Joah-wu/Acho/acho/Hardware/PCBs/README.md

# PCB资料

| 目录 | 内容 |
| --- | --- |
| `Acho_Main` | 主板原理图、BOM、交互BOM与Gerber压缩包 |
| `Audio_Core` | 音频子板原理图、BOM、交互BOM与Gerber压缩包 |

原理图用于连接与电源检查，BOM用于选型和采购，Gerber用于制造，交互BOM用于装配定位。以当前目录实际保留的文件为准。

主板承载STM32、显示、SD、NFC、ESP32接口和用户交互；音频子板承载WM8960、功放/扬声器相关电路。两块板的连接、供电和信号定义应以各自原理图为准。
