Joah-wu/Acho/model/README.md

# model

关键词识别模型及配套脚本。

| 路径 | 作用 |
| --- | --- |
| `keyword_spotting/` | 模型网络、数据处理、训练与推理代码 |
| `scripts/` | 数据准备、训练、测试与ONNX导出脚本 |
| `*.onnx` / 模型资源 | 提供给X-CUBE-AI或离线验证的模型文件 |

Python缓存和训练输出为本地过程文件，不应提交。

模型用于离线关键词识别；需要部署到STM32时，使用导出的ONNX模型交给X-CUBE-AI生成推理代码。训练数据、检查点和实验日志应与可复现的脚本配置分开管理。
