Joah-wu/Acho/acho/Hardware/PCBs/Acho_Main/BOM_Acho-main.xlsx

No. | Quantity | Comment | Designator | Footprint | Value | Device | Supplier | Supplier Part | Manufacturer | Manufacturer Part | Tolerance
1 | 1 | 4000Hz | BUZZER1 | BUZ-SMD_L5.0-W5.5-P4.60 | 4000Hz | 5020蜂鸣器 | LCSC | C94598 | 华能 | MLT-5020
2 | 18 | 100nF | C1,C5,C6,C9,C10,C11,C12,C13,C14,C17,C19,C27,C28,C38,C44,C45,C48,C49 | C0402 | 100nF | CAP_0402
3 | 2 | 12pF | C2,C3 | C0402 | 12pF | CAP_0402
4 | 2 | 20pF | C4,C7 | C0402 | 20pF | CAP_0402
5 | 5 | 10uF | C8,C18,C26,C29,C47 | C0603 | 10uF | CAP_0603
6 | 2 | 22uf | C34,C36 | C0603 |  | 22uf
7 | 2 | 4.7uF | C42,C50 | C0603 | 4.7uF | CL10A475KO8NNNC | LCSC | C19666 | SAMSUNG(三星) | CL10A475KO8NNNC | ±10%
8 | 1 | 1uF | C46 | C0402 | 1uF | CAP_0402
9 | 2 | SS34-A | D1,D2 | SMA_L4.3-W2.6-LS5.2-RD |  | SS34-A | LCSC | C143201 | FMS(美丽微) | SS34-A
10 | 1 | DSS14 | D6 | SOD-123_L2.8-W1.8-LS3.7-RD |  | DSS14 | LCSC | C59293 | STARSEA | DSS14
11 | 1 | 4.7uH-INDUCTOR-0603 | L2 | IND-SMD_L1.6-W1.0 |  | 10uH-INDUCTOR-0603 | LCSC | C9900016650 | YJYCOIN(益嘉源) | 4.7uH-INDUCTOR-0603
12 | 1 | FCM1608KF-601T03 | L4 | L0603 |  | FCM1608KF-601T03 | LCSC | C141723 | TAI-TECH(台庆) | FCM1608KF-601T03 | ±25%
13 | 1 | LED_0603-G | LED2 | LED_0603 |  | LED_0603-G
14 | 1 | LED_0603-R | LED3 | LED_0603 |  | LED_0603-R
15 | 1 | S8550 | Q1 | SOT-23-3_L2.9-W1.3-P1.90-LS2.4-BR |  | S8550 | LCSC | C2931720 | Doeshare(德芯) | S8550
16 | 1 | S8050_SOT_NPN | Q4 | S8050_SOT-23 |  | S8050_SOT_NPN
17 | 15 | 10K | R1,R2,R3,R6,R7,R13,R18,R19,R20,R21,R22,R29,R31,R71,R72 | R0402 | 10K | Res_0402
18 | 3 | 2K | R4,R5,R36 | R0402 | 2K | Res_0402
19 | 2 | 5.1K | R8,R9 | R0402 | 10K | Res_0402
20 | 1 | 10K | R11 | R0603 | 10K | Res_0603
21 | 2 | 0 | R14,R15 | R0603 | 0 | Res_0603
22 | 2 | 1.2K | R16,R32 | R0402 | 1.2K | Res_0402
23 | 3 | 47K | R25,R26,R27 | R0402 | 10K | Res_0402
24 | 1 | 0Ω | R69 | R0805 | 0Ω | 0805W8F0000T5E | LCSC | C17477 | UNI-ROYAL(厚声) | 0805W8F0000T5E | ±1%
25 | 1 | 三脚开关 | SW1 | 拨动开关封装 |  | 三脚开关
26 | 1 | Test-Point | TP1 | Test-Point-0.5mm |  | Test-Point
27 | 1 | STM32F446RET6 | U1 | LQFP-64_L10.0-W10.0-P0.50-LS12.0-BL |  | STM32F446RET6 | LCSC | C69336 | ST(意法半导体) | STM32F446RET6
28 | 2 | 二脚小龟直 | U2,U24 | KEY-SMD_L3.9-W3.0-LS5.0 |  | 二脚小龟直 | LCSC | C2940098 |  | 二脚小龟直
29 | 1 | 13.56MHz | U3 | SO-8_L4.9-W3.9-P1.27-LS6.0-BL | 13.56MHz | ST25DV64KC-IE6S3 | LCSC | C3304275 | ST(意法半导体) | ST25DV64KC-IE6S3
30 | 1 | CH549F | U4 | QFN-28_L4.0-W4.0-P0.40-BL-EP |  | CH549F | LCSC | C367229 | WCH(南京沁恒) | CH549F
31 | 1 | BX-SH1.0-3PLT | U5 | CONN-SMD_3P-P1.00_BX-SH1.0-3PLT |  | BX-SH1.0-3PLT | LCSC | C18077916 | Bossie(博锡) | BX-SH1.0-3PLT
32 | 1 | TP4056 | U7 | ESOP-8_L4.9-W3.9-P1.27-LS6.0-BL-EP |  | TP4056 | LCSC | C9900002169 |  | TP4056
33 | 1 | SIQ-02FVS3 | U9 | SW-SMD_SIQ-02FVS3_1 |  | SIQ-02FVS3 | LCSC | C2925423 | MITSUMI(美上美) | SIQ-02FVS3
34 | 1 | 自弹TF卡座TFAA | U10 | SIM-SMD_C9900015645 |  | TF_Card | LCSC | C9900015645 | null | 自弹TF卡座TFAA
35 | 2 | AO3401 | U11,U12 | SOT-23-3_L2.9-W1.6-P1.90-LS2.8-BR |  | AO3401 | LCSC | C9900008520 |  | AO3401
36 | 1 | FUSE0603 | U13 | F0603 |  | FUSE0603 | LCSC | C9900023011 |  | FUSE0603
37 | 1 | RT9013-33GB | U14 | SOT-23-5_L2.9-W1.6-P0.95-LS2.8-BR |  | RT9013-33GB_C19268157 | LCSC | C19268157 | TECH PUBLIC(台舟) | RT9013-33GB
38 | 1 | Acho音频模块接口 | U15 | Acho音频模块接口封装 |  | Acho音频模块接口
39 | 1 | SX1308 | U17 | SOT-23-6_L2.9-W1.6-P0.95-LS2.8-BR |  | SX1308 | LCSC | C78162 | SX | SX1308
40 | 1 | 1N4148 | U19 | SOD-123_L2.7-W1.7-LS3.8-RD |  | 1N4148 | LCSC | C9900009645 |  | 1N4148
41 | 1 | BX-SH1.0-2PWT | U20 | CONN-SMD_2P-P1.00_BX-SH1.0-2PWT |  | BX-SH1.0-2PWT | LCSC | C18077908 | Bossie(博锡) | BX-SH1.0-2PWT
42 | 1 | FPC10-0.5 | U22 | FPC-SMD_P0.5-10P_FGS-XJ-H2.0 |  | FPC10-0.5 | LCSC | C9900025035 |  | FPC10-0.5
43 | 1 | ESP32-C3-MINI-1-N4 | U23 | WIFIM-SMD_ESP32-C3-MINI-1 |  | ESP32-C3-MINI-1-N4 | LCSC | C2838502 | ESPRESSIF(乐鑫) | ESP32-C3-MINI-1-N4
44 | 1 | KH-TYPE-C-16P | USB1 | USB-C-SMD_KH-TYPE-C-16P |  | USB-TYPE-C-16P | LCSC | C709357 | kinghelm(金航标) | KH-TYPE-C-16P
45 | 1 | 32.768kHz | X1 | OSC-SMD_L3.2-W1.5 | 32.768kHz | X321532768KGD2SI | LCSC | C620155 | YXC(扬兴晶振) | X321532768KGD2SI
46 | 1 | 12MHz | X2 | OSC-SMD_4P-L3.2-W2.5-BL | 12MHz | X322512MSB4SI | LCSC | C9002 | YXC(扬兴晶振) | X322512MSB4SI
