Joah-wu/Acho/acho/Hardware/PCBs/Audio_Core/BOM_audio-core.xlsx

No. | Quantity | Comment | Designator | Footprint | Value | Device | Supplier | Supplier Part | Manufacturer | Manufacturer Part | Tolerance
1 | 6 | 100nF | C1,C5,C8,C9,C10,C11 | C0603 | 100nF | CAP_0603
2 | 3 | 10uF | C2,C3,C4 | C0603 | 10uF | CAP_0603
3 | 3 | 1uF | C6,C7,C12 | C0603 | 1uF | CAP_0603
4 | 1 | PJ-393 | CN1 | AUDIO-TH_PJ-393 |  | PJ-393 | LCSC | C920237 | XUNPU(讯普) | PJ-393
5 | 1 | 2.54-1*10P针 | H1 | HDR-TH_10P-P2.54-V-M-1 |  | HDR-M_2.54_1x10P | LCSC | C57369 | BOOMELE(博穆精密) | 2.54-1*10P针
6 | 1 | Acho音频模块扬声器接口 | H2 | Acho音频模块扬声器接口封装 |  | Acho音频模块扬声器接口
7 | 1 | LED_0603-G | LED1 | LED_0603 |  | LED_0603-G
8 | 1 | AOS3729A-T42-NXC | MIC1 | MIC-SMD_L3.8-W3.00-TL |  | AOS3729A-T42-NXC | LCSC | C338759 | SANICO(莎尼可) | AOS3729A-T42-NXC
9 | 2 | 2.2K | R1,R2 | R0603 | 2.2K | Res_0603
10 | 5 | 10K | R3,R4,R5,R7,R10 | R0603 | 10K | Res_0603
11 | 1 | 0 | R6 | R0603 | 0 | Res_0603
12 | 1 | 47K | R8 | R0603 | 47K | Res_0603
13 | 1 | 15K | R9 | R0603 | 15K | Res_0603
14 | 1 | WM8960CGEFL/RV | U1 | qfn-32_l5.0-w5.0-p0.50-tl-ep3.5 |  | WM8960CGEFL/RV_C323847 | LCSC | C323847 |  | WM8960CGEFL/RV
