Joah-wu/Acho/acho/Hardware/Solids/上框.SLDPRT

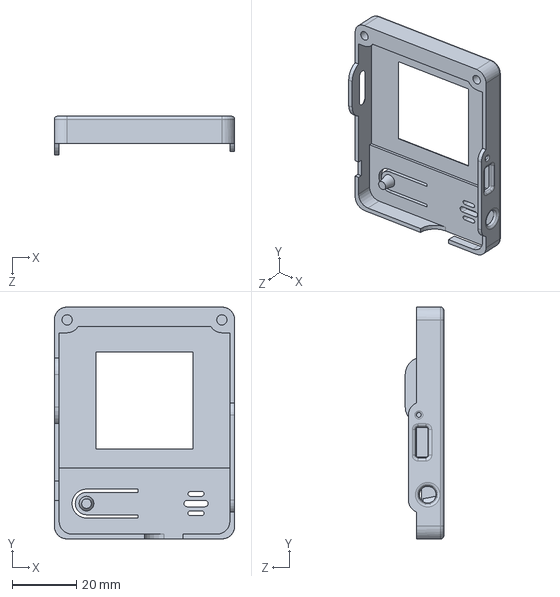
[picture p42: CAD file, 2026-11-07]
acho/Hardware/Solids/上框.SLDPRT
56.0 x 72.0 x 12.0 mm
