Joah-wu/Acho/acho/Hardware/Solids/下框.SLDPRT

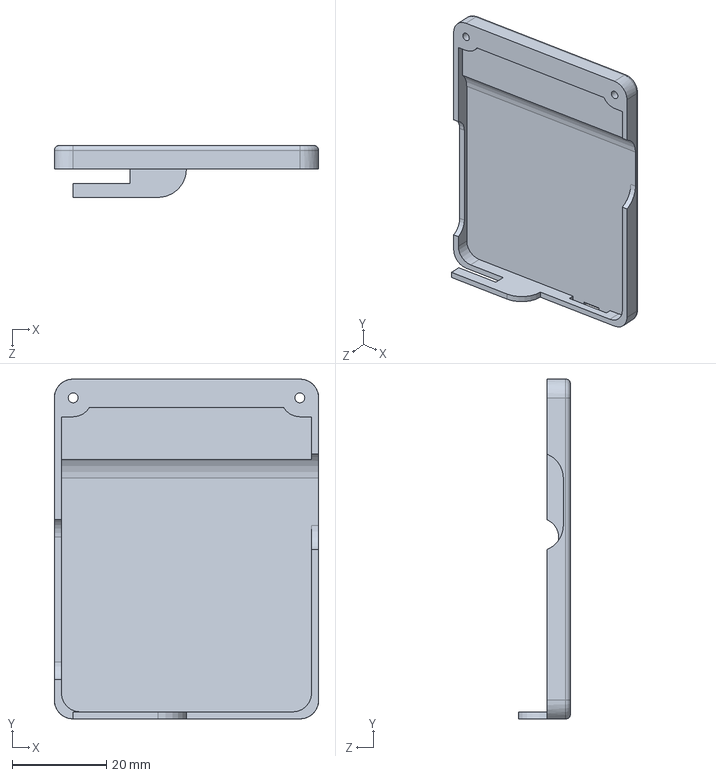
[picture p43: CAD file, 2026-11-07]
acho/Hardware/Solids/下框.SLDPRT
56.0 x 72.0 x 11.0 mm
