Joah-wu/Acho/acho/Hardware/Solids/acho_audio_kit.step

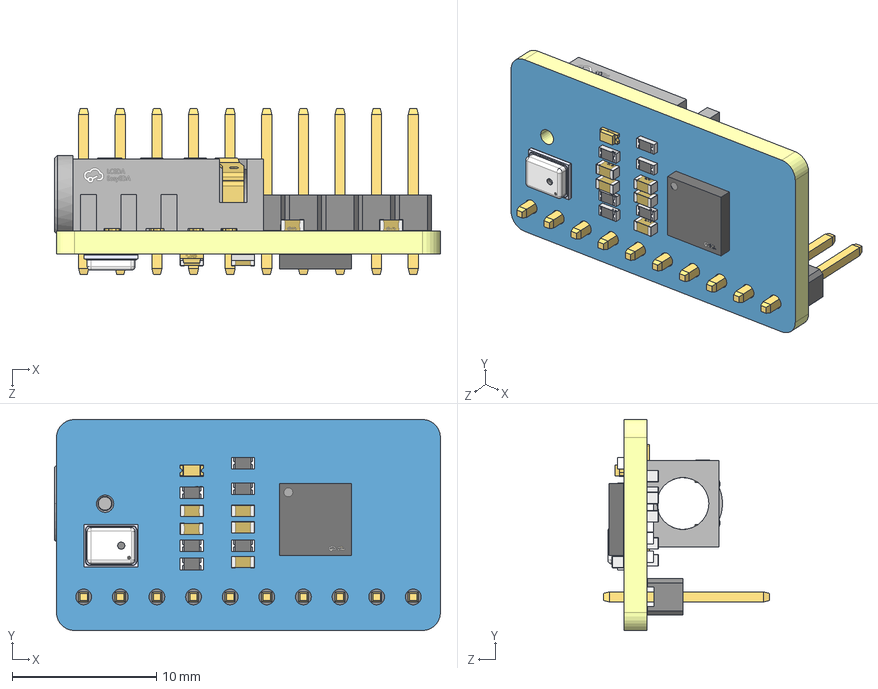
[picture p44: CAD file, 2026-11-07]
acho/Hardware/Solids/acho_audio_kit.step
26.8 x 14.6 x 11.5 mm
COMPOUND.step.step.step.step
COMPOUND-0.step.step.step.step x 10
COMPOUND-1.step.step.step.step
SOLID.step.step.step.step x 12
COMPOUND-2.step.step.step.step
COMPOUND-3.step.step.step.step
COMPOUND-4.step.step.step.step
Board.step.step.step.step
