Joah-wu/Acho/(list of files, cad)

Other CAD files:
acho/Hardware/Solids/acho_pcb.step
acho/Hardware/Solids/acho_pcb.SLDASM
