Joah-wu/Acho/acho/Hardware/PCBs/Audio_Core/SCH_audio-core-sch.pdf

### AGND

# C2 ¹⁰uF

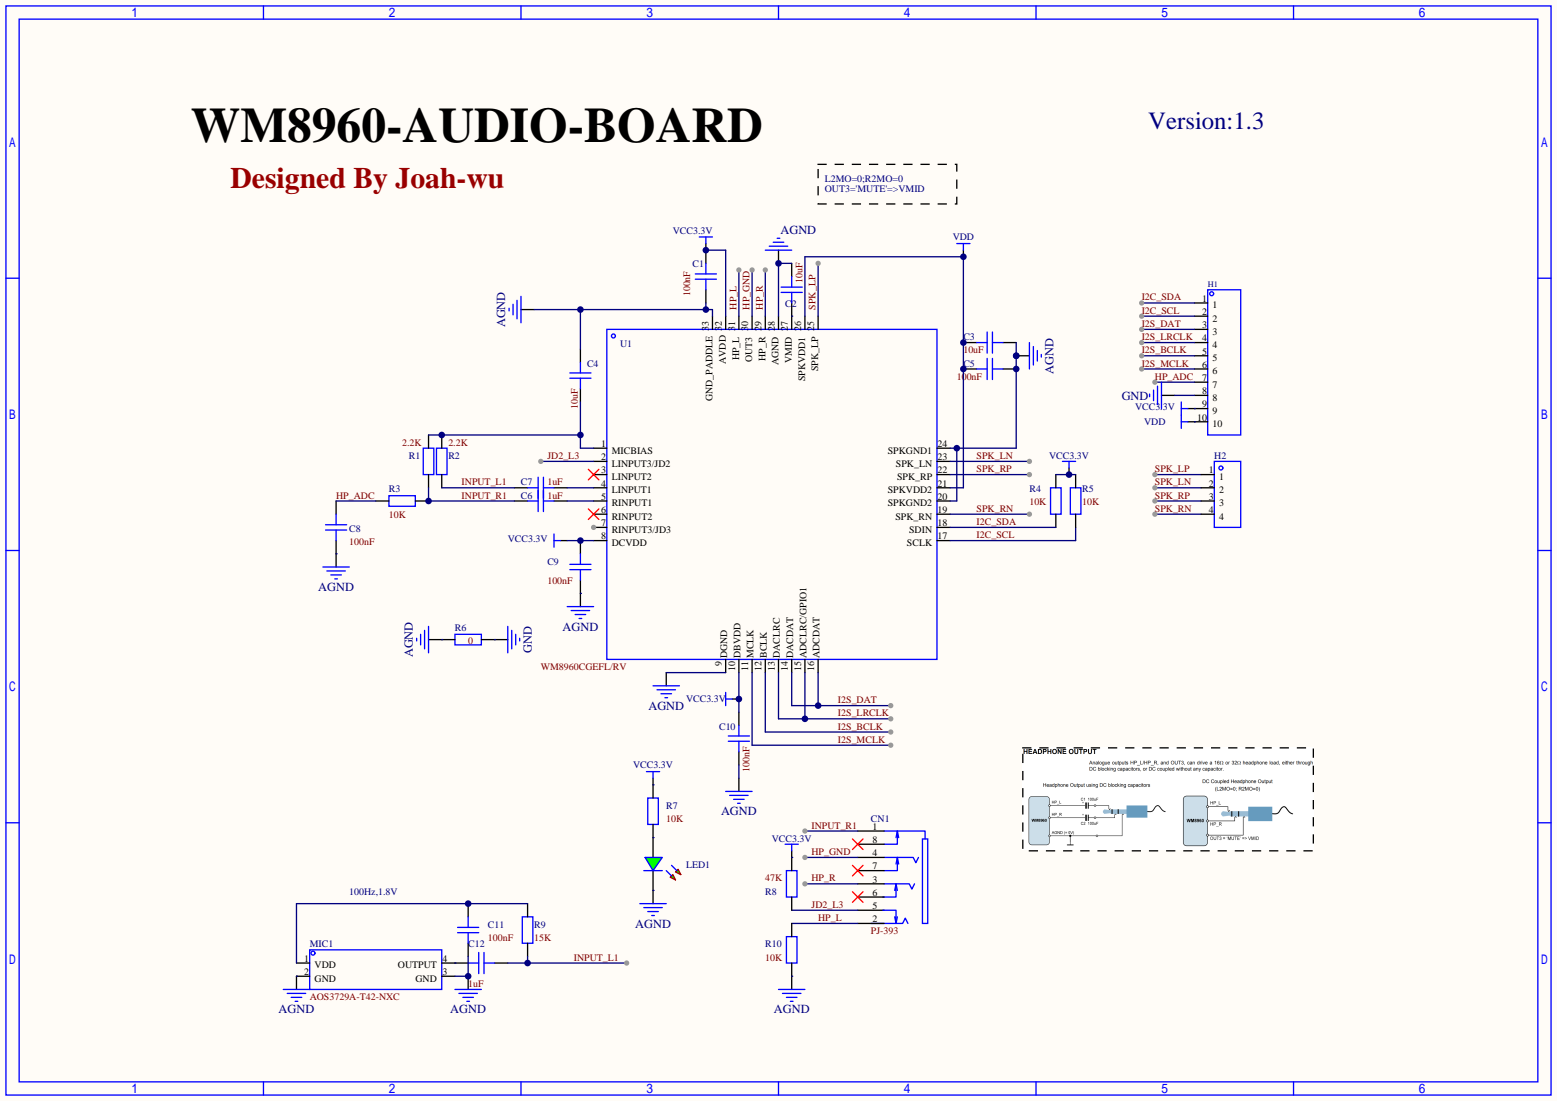
[picture p45: page 1]

WM8960-AUDIO-BOARD
Designed By Joah-wu AGND
