Joah-wu/Acho/acho/Hardware/PCBs/Acho_Main/SCH_Acho-sch.pdf

# 48 PA14 49 PA15 50 PC10 51 PC11 52 PC12 53 PD2 54 PB3 55 PB4 56 PB5 57 PB6

### GND

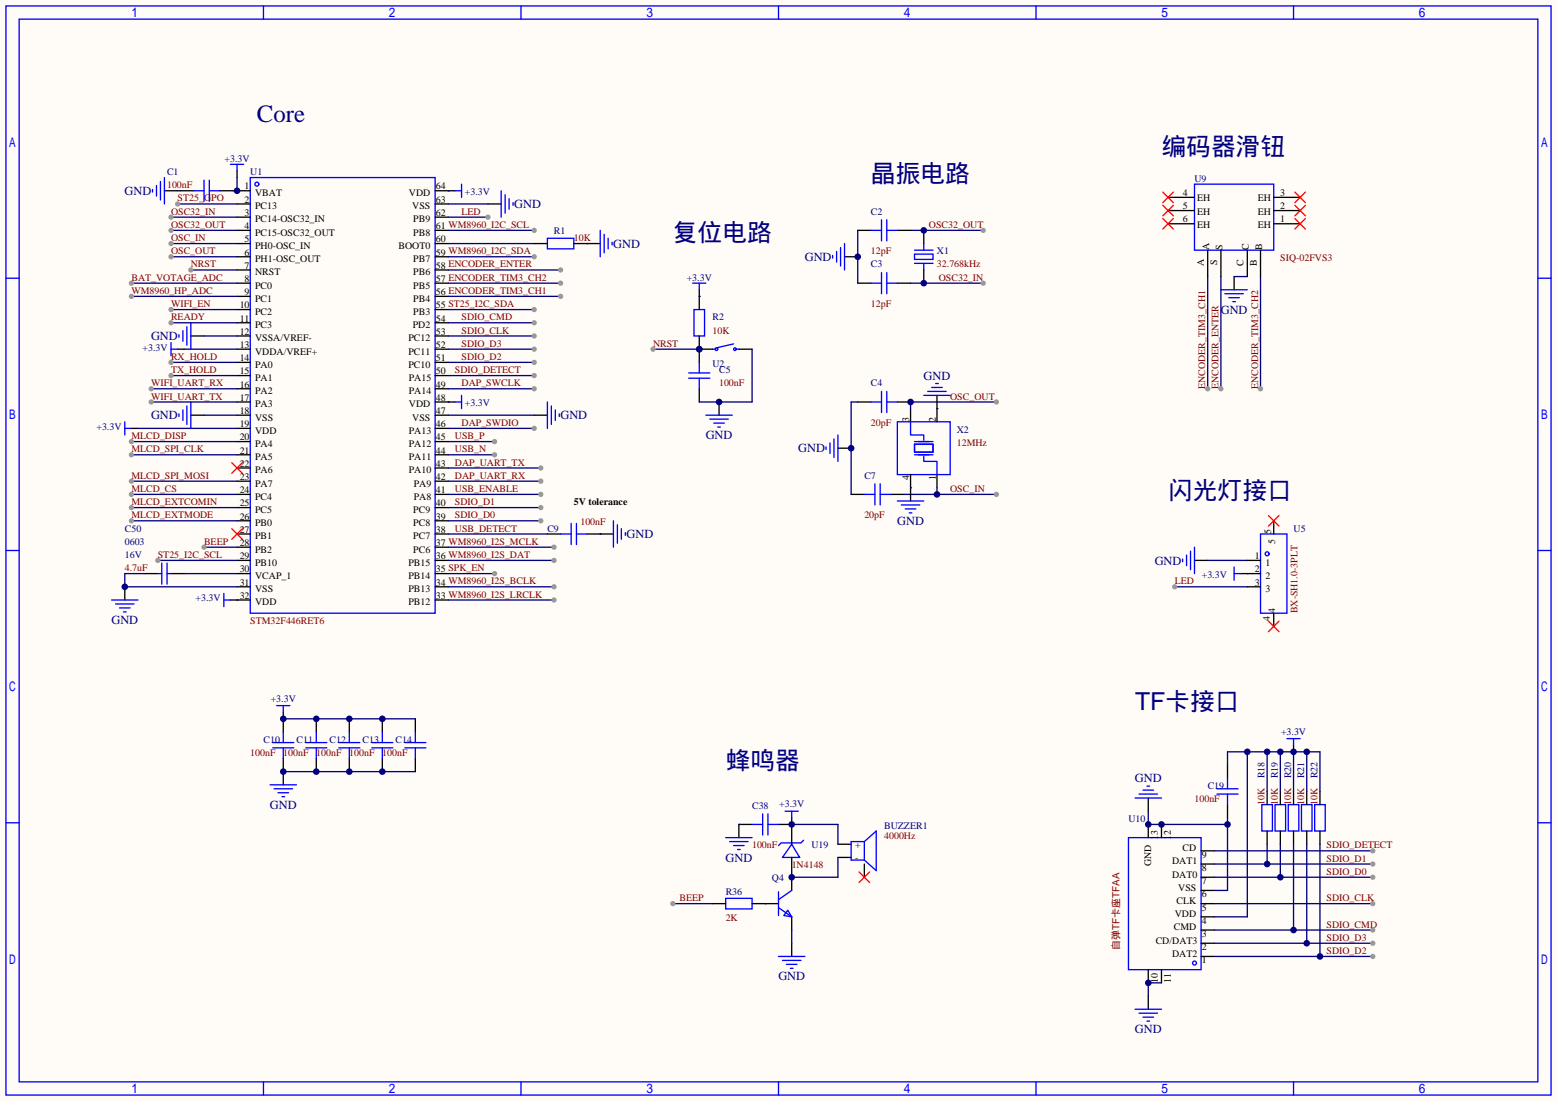
[picture p46: page 1]

### GND

### GND

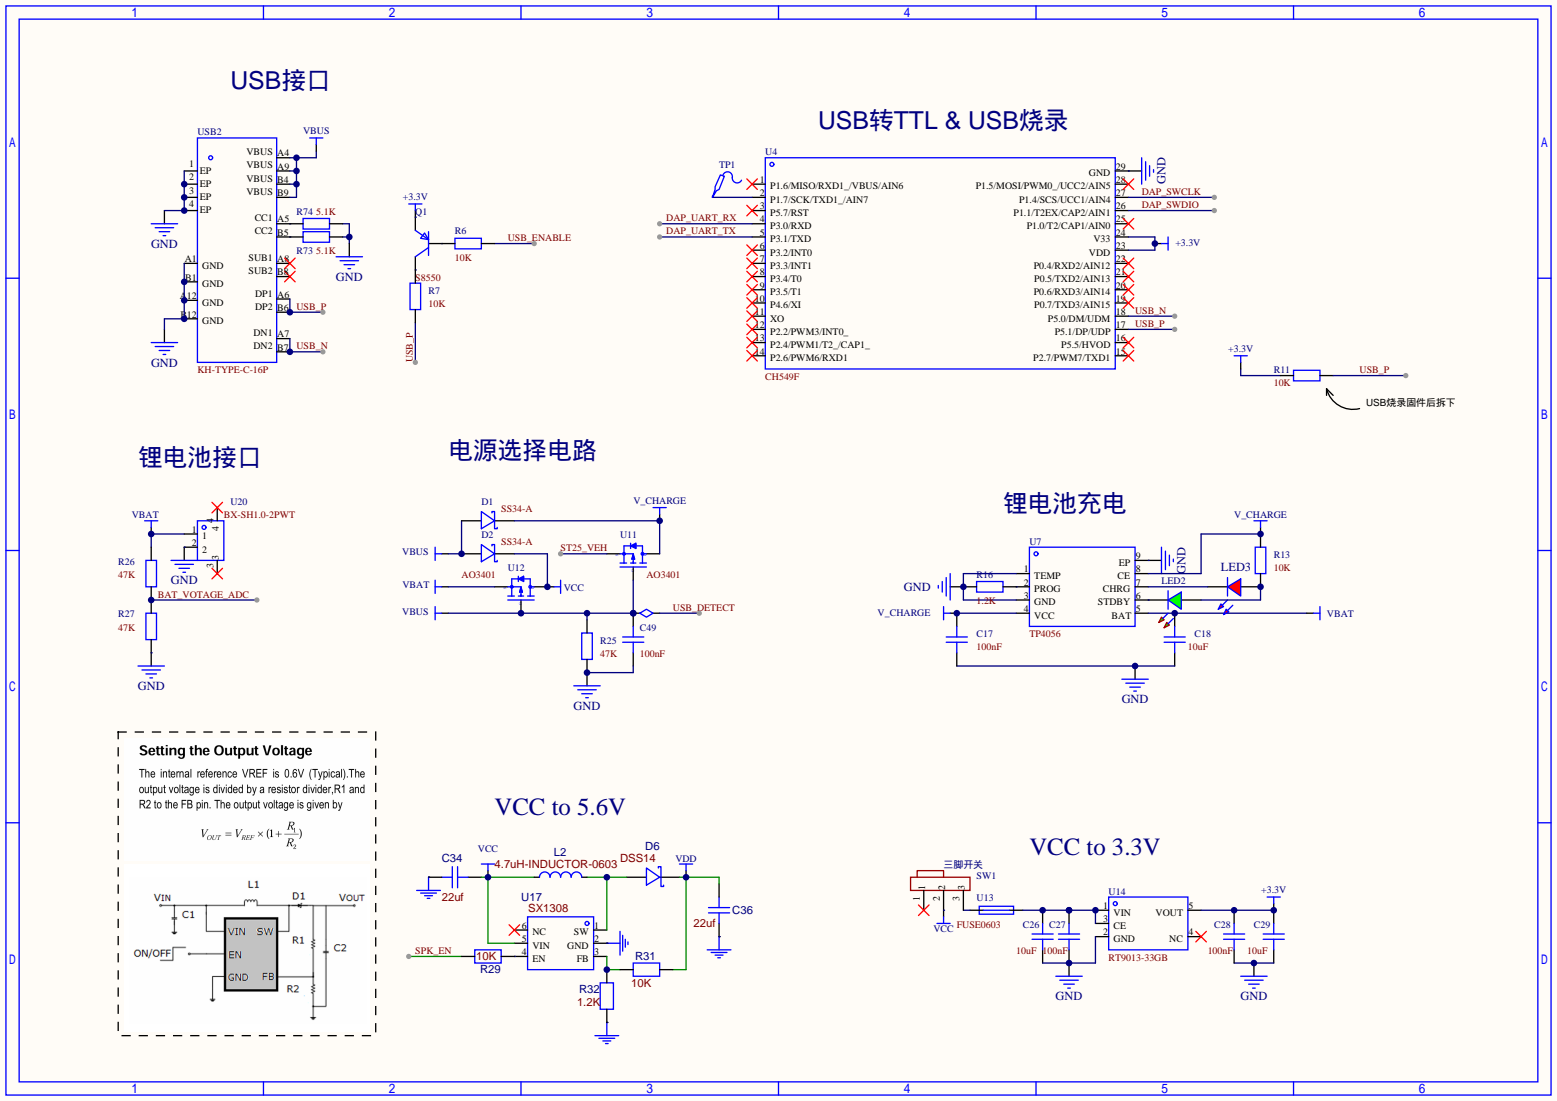
[picture p47: page 2]

### GND

# NFC

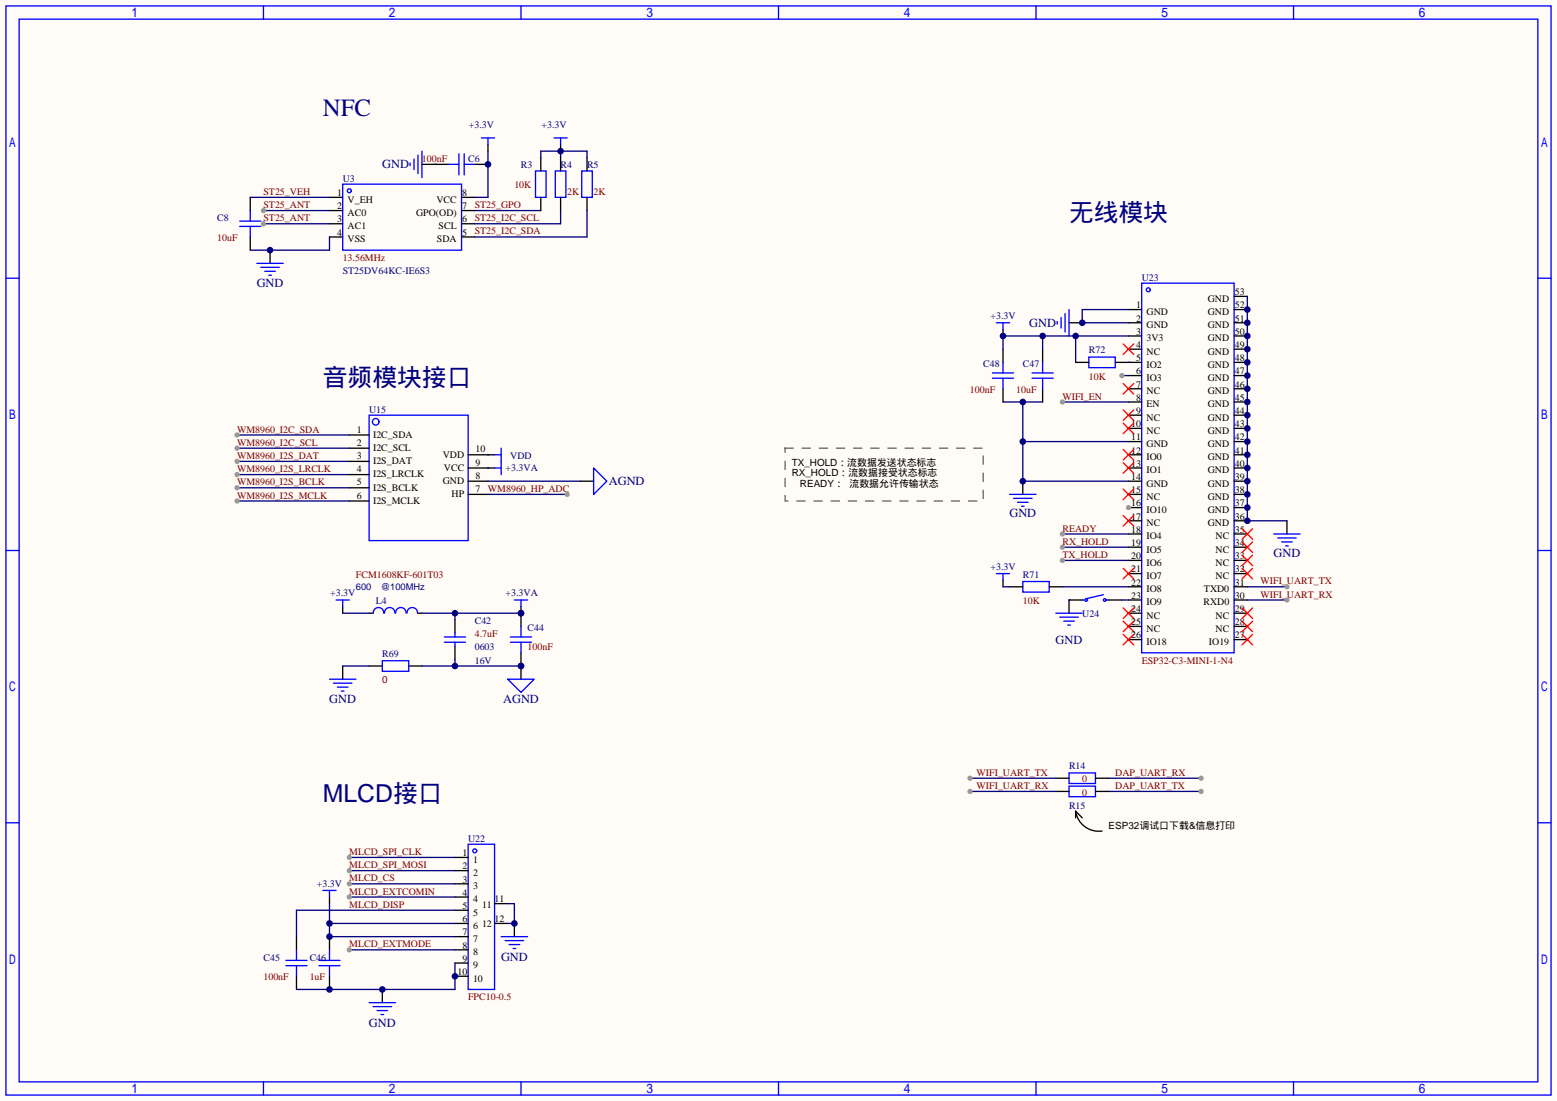
[picture p48: page 3]
