Joah-wu/Acho/acho/Hardware/PCBs/Audio_Core/SCH_audio-core-sch_2026-11-06.pdf

### AGND

# C2 ¹⁰uF

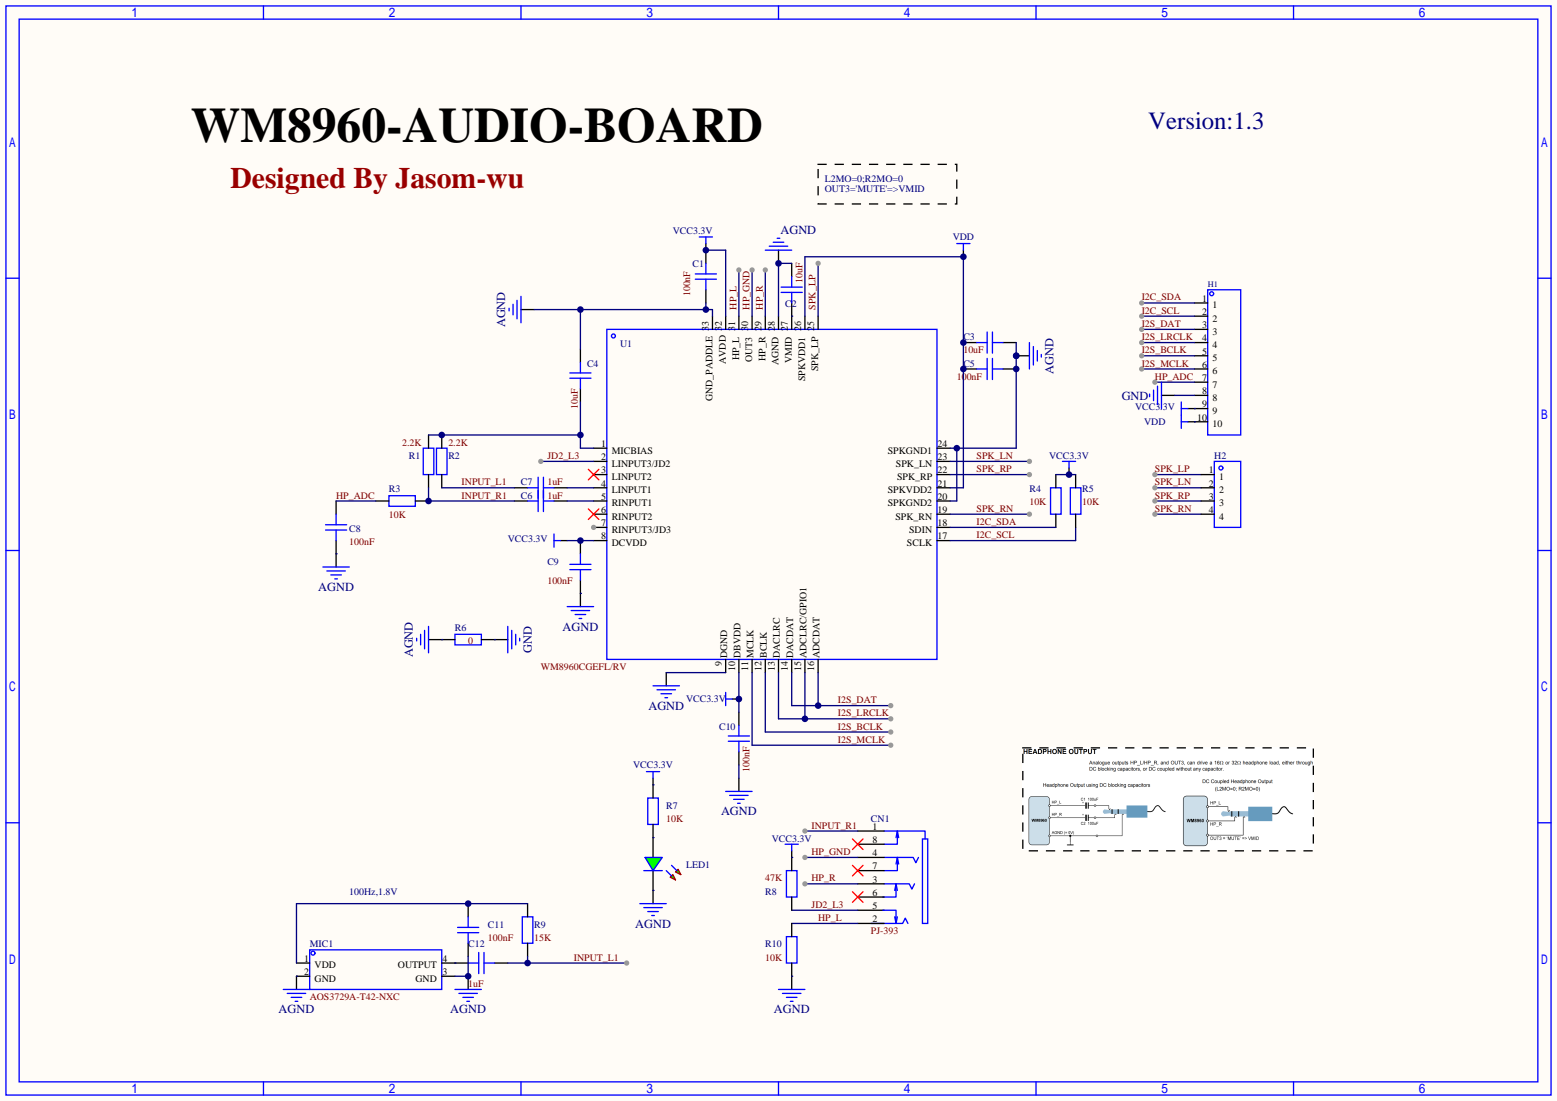
[picture p49: page 1]

WM8960-AUDIO-BOARD
Designed By Jasom-wu AGND
