Joah-wu/Acho/acho/Firmware/stm32f446/Core/Src/i2s.c

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
/* Includes ------------------------------------------------------------------*/
#include "i2s.h"

/* USER CODE BEGIN 0 */
DMA_HandleTypeDef hdma_spi2_rx;
/* USER CODE END 0 */

I2S_HandleTypeDef hi2s2;
DMA_HandleTypeDef hdma_spi2_tx;

/* I2S2 init function */
void MX_I2S2_Init(void)
{

  hi2s2.Instance = SPI2;
  hi2s2.Init.Mode = I2S_MODE_MASTER_TX;
  hi2s2.Init.Standard = I2S_STANDARD_PHILIPS;
  hi2s2.Init.DataFormat = I2S_DATAFORMAT_16B;
  hi2s2.Init.MCLKOutput = I2S_MCLKOUTPUT_ENABLE;
  hi2s2.Init.AudioFreq = I2S_AUDIOFREQ_8K;
  hi2s2.Init.CPOL = I2S_CPOL_LOW;
  hi2s2.Init.ClockSource = I2S_CLOCK_PLL;
  hi2s2.Init.FullDuplexMode = I2S_FULLDUPLEXMODE_DISABLE;
  if (HAL_I2S_Init(&hi2s2) != HAL_OK)
  {
    Error_Handler();
  }
}

void HAL_I2S_MspInit(I2S_HandleTypeDef* i2sHandle)
{

  GPIO_InitTypeDef GPIO_InitStruct = {0};
  RCC_PeriphCLKInitTypeDef PeriphClkInitStruct = {0};
  if(i2sHandle->Instance==SPI2)
  {
  /** Initializes the peripherals clock
  */
    PeriphClkInitStruct.PeriphClockSelection = RCC_PERIPHCLK_I2S_APB1;
    PeriphClkInitStruct.PLLI2S.PLLI2SN = 50;
    PeriphClkInitStruct.PLLI2S.PLLI2SP = RCC_PLLI2SP_DIV2;
    PeriphClkInitStruct.PLLI2S.PLLI2SM = 6;
    PeriphClkInitStruct.PLLI2S.PLLI2SR = 2;
    PeriphClkInitStruct.PLLI2S.PLLI2SQ = 2;
    PeriphClkInitStruct.PLLI2SDivQ = 1;
    PeriphClkInitStruct.I2sApb1ClockSelection = RCC_I2SAPB1CLKSOURCE_PLLI2S;
    if (HAL_RCCEx_PeriphCLKConfig(&PeriphClkInitStruct) != HAL_OK)
    {
      Error_Handler();
    }

    /* I2S2 clock enable */
    __HAL_RCC_SPI2_CLK_ENABLE();

    __HAL_RCC_GPIOB_CLK_ENABLE();
    __HAL_RCC_GPIOC_CLK_ENABLE();
    /**I2S2 GPIO Configuration
    PB12     ------> I2S2_WS
    PB13     ------> I2S2_CK
    PB15     ------> I2S2_SD
    PC6     ------> I2S2_MCK
    */
    GPIO_InitStruct.Pin = WM8960_I2S_LRCLK_Pin|WM8960_I2S_BCLK_Pin|WM8960_I2S_DAT_Pin;
    GPIO_InitStruct.Mode = GPIO_MODE_AF_PP;
    GPIO_InitStruct.Pull = GPIO_NOPULL;
    GPIO_InitStruct.Speed = GPIO_SPEED_FREQ_LOW;
    GPIO_InitStruct.Alternate = GPIO_AF5_SPI2;
    HAL_GPIO_Init(GPIOB, &GPIO_InitStruct);

    GPIO_InitStruct.Pin = WM8960_I2S_MCLK_Pin;
    GPIO_InitStruct.Mode = GPIO_MODE_AF_PP;
    GPIO_InitStruct.Pull = GPIO_NOPULL;
    GPIO_InitStruct.Speed = GPIO_SPEED_FREQ_LOW;
    GPIO_InitStruct.Alternate = GPIO_AF5_SPI2;
    HAL_GPIO_Init(WM8960_I2S_MCLK_GPIO_Port, &GPIO_InitStruct);

    /* I2S2 DMA Init */
    /* SPI2_TX Init */
    hdma_spi2_tx.Instance = DMA1_Stream4;
    hdma_spi2_tx.Init.Channel = DMA_CHANNEL_0;
    hdma_spi2_tx.Init.Direction = DMA_MEMORY_TO_PERIPH;
    hdma_spi2_tx.Init.PeriphInc = DMA_PINC_DISABLE;
    hdma_spi2_tx.Init.MemInc = DMA_MINC_ENABLE;
    hdma_spi2_tx.Init.PeriphDataAlignment = DMA_PDATAALIGN_HALFWORD;
    hdma_spi2_tx.Init.MemDataAlignment = DMA_MDATAALIGN_HALFWORD;
    hdma_spi2_tx.Init.Mode = DMA_NORMAL;
    hdma_spi2_tx.Init.Priority = DMA_PRIORITY_LOW;
    hdma_spi2_tx.Init.FIFOMode = DMA_FIFOMODE_DISABLE;
    if (HAL_DMA_Init(&hdma_spi2_tx) != HAL_OK)
    {
      Error_Handler();
    }

    __HAL_LINKDMA(i2sHandle,hdmatx,hdma_spi2_tx);

  /* USER CODE BEGIN SPI2_MspInit 1 */

    /* Keep application streaming settings across CubeMX regeneration. */
    hdma_spi2_tx.Init.Mode = DMA_CIRCULAR;
    hdma_spi2_tx.Init.Priority = DMA_PRIORITY_HIGH;
    if (HAL_DMA_Init(&hdma_spi2_tx) != HAL_OK)
    {
      Error_Handler();
    }
    /* SPI2_RX Init */
    hdma_spi2_rx.Instance = DMA1_Stream3;
    hdma_spi2_rx.Init.Channel = DMA_CHANNEL_0;
    hdma_spi2_rx.Init.Direction = DMA_PERIPH_TO_MEMORY;
    hdma_spi2_rx.Init.PeriphInc = DMA_PINC_DISABLE;
    hdma_spi2_rx.Init.MemInc = DMA_MINC_ENABLE;
    hdma_spi2_rx.Init.PeriphDataAlignment = DMA_PDATAALIGN_HALFWORD;
    hdma_spi2_rx.Init.MemDataAlignment = DMA_MDATAALIGN_HALFWORD;
    hdma_spi2_rx.Init.Mode = DMA_CIRCULAR;
    hdma_spi2_rx.Init.Priority = DMA_PRIORITY_HIGH;
    hdma_spi2_rx.Init.FIFOMode = DMA_FIFOMODE_DISABLE;
    if (HAL_DMA_Init(&hdma_spi2_rx) != HAL_OK)
    {
      Error_Handler();
    }

    __HAL_LINKDMA(i2sHandle,hdmarx,hdma_spi2_rx);
    /* RX has a separate DMA request even though PB15 is shared in half duplex. */
    HAL_NVIC_SetPriority(DMA1_Stream3_IRQn, 6, 0);
    HAL_NVIC_EnableIRQ(DMA1_Stream3_IRQn);
  /* USER CODE END SPI2_MspInit 1 */
  }
}

void HAL_I2S_MspDeInit(I2S_HandleTypeDef* i2sHandle)
{

  if(i2sHandle->Instance==SPI2)
  {
    /* Peripheral clock disable */
    __HAL_RCC_SPI2_CLK_DISABLE();

    /**I2S2 GPIO Configuration
    PB12     ------> I2S2_WS
    PB13     ------> I2S2_CK
    PB15     ------> I2S2_SD
    PC6     ------> I2S2_MCK
    */
    HAL_GPIO_DeInit(GPIOB, WM8960_I2S_LRCLK_Pin|WM8960_I2S_BCLK_Pin|WM8960_I2S_DAT_Pin);

    HAL_GPIO_DeInit(WM8960_I2S_MCLK_GPIO_Port, WM8960_I2S_MCLK_Pin);

    /* I2S2 DMA DeInit */
    HAL_DMA_DeInit(i2sHandle->hdmatx);
  /* USER CODE BEGIN SPI2_MspDeInit 1 */
    HAL_DMA_DeInit(i2sHandle->hdmarx);
    HAL_NVIC_DisableIRQ(DMA1_Stream3_IRQn);
  /* USER CODE END SPI2_MspDeInit 1 */
  }
}
