Joah-wu/Acho/(commit log)

2026-10-31 上传误删库前最后的版本
    [DapLink.cfg, st_nucleo_f103rb.cfg]
2026-11-03 基本外设适配完成，屏幕与ui适配完成，音频待验证
2026-11-04 音频驱动大改并适配完成，优化select与audio UI逻辑动画更流畅，音频Apps逻辑重构，加入调试信息，双半区循环DMA配合中断，使用任务通知机制让出任务运行资源
2026-11-07 feat: 补齐 Acho 多端工程整合与功能文档 - 使用dmabuff一次发送整帧与imgcache，改原先select、audio双图像机制为单图像，各文件打开采用lv_mem动态分配避免同file对象访问冲突，大幅优化各ui刷新速度，显示更丝滑 - stm32取消uart1输出调试，采用dap-rtt输出logs，避免tx干扰uart2与esp32的uart0通信 - 主菜单加入esp3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
    [BOM_Acho-main.xlsx, BOM_audio-core.xlsx, DapLink.cfg, ProProject_Acho.epro, acho_audio_kit.step, acho_pcb.SLDASM, acho_pcb.step, buttonshapewhitebg.xml]
2026-11-09 更新pcb原理图，整理文档，添加paper.pdf
