Joah-wu/Acho/(notices)

Notices in the files:
acho/Firmware/stm32f446/Core/Src/main.c:
Copyright (c) 2022 STMicroelectronics.
All rights reserved.
This software is licensed under terms that can be found in the LICENSE file
acho/Firmware/stm32f446/Core/Src/i2s.c:
Copyright (c) 2025 STMicroelectronics.
